JohnRaines/outlet-regulator/project/keypad wiring diagram (rev2).txt

keypad pin wiring

rows: (pin, gpio)
24, 8
26, 7
32, 12
36, 16

columns: (pin, gpio)
38, 20
40, 21
37, 26
