JohnRaines/outlet-regulator/project/baseplate 1.STL

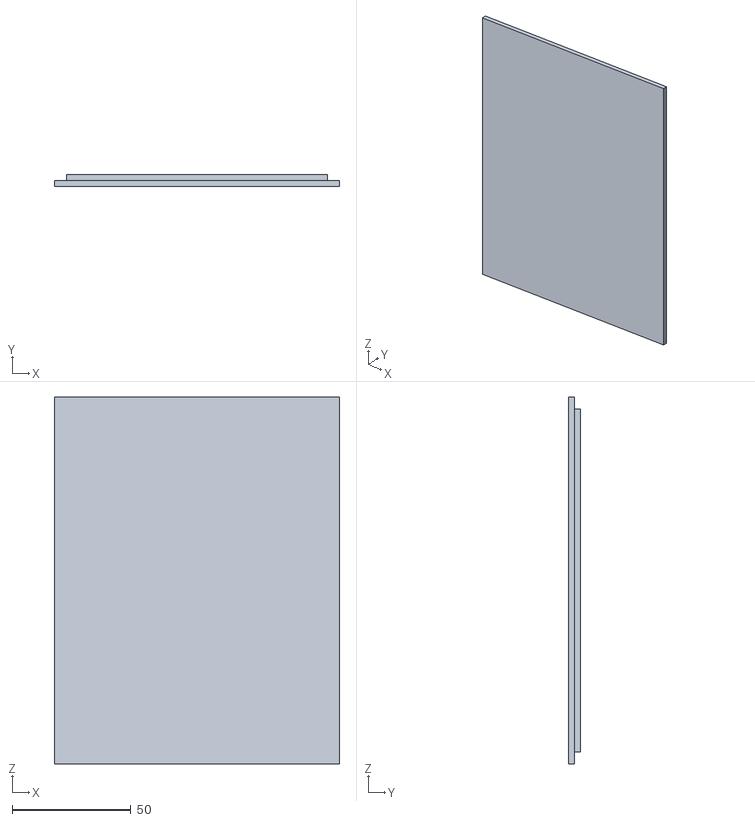
[picture p1: CAD file, 2017-04-18]
project/baseplate 1.STL
120.0 x 5.00 x 154.5
