JohnRaines/outlet-regulator/project/box 2 (holes).STL

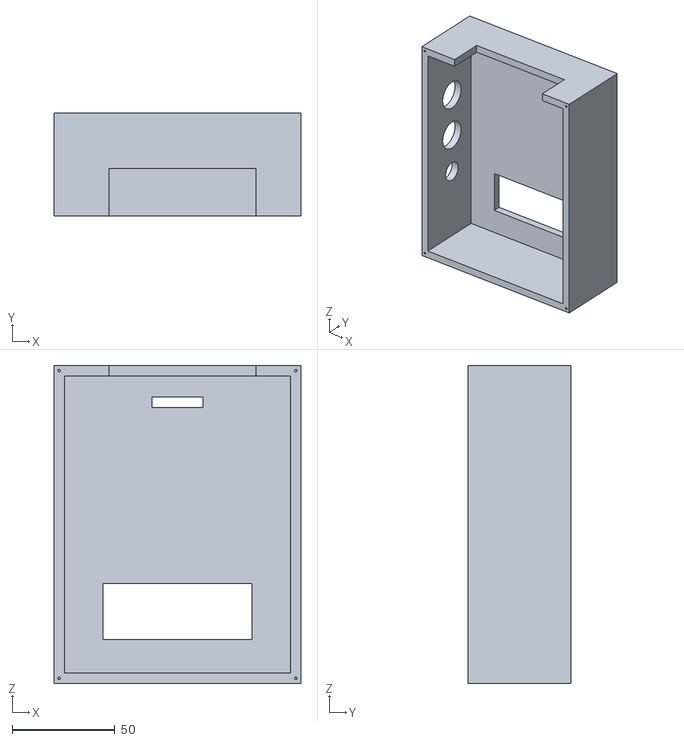
[picture p2: CAD file, 2017-04-18]
project/box 2 (holes).STL
120.0 x 50.0 x 154.5
