JohnRaines/outlet-regulator/project/Eagle Files/breakout rev 2.1.1/wiring.brd

## EAGLE design project/Eagle Files/breakout rev 2.1.1/wiring.brd (2017-02-02)

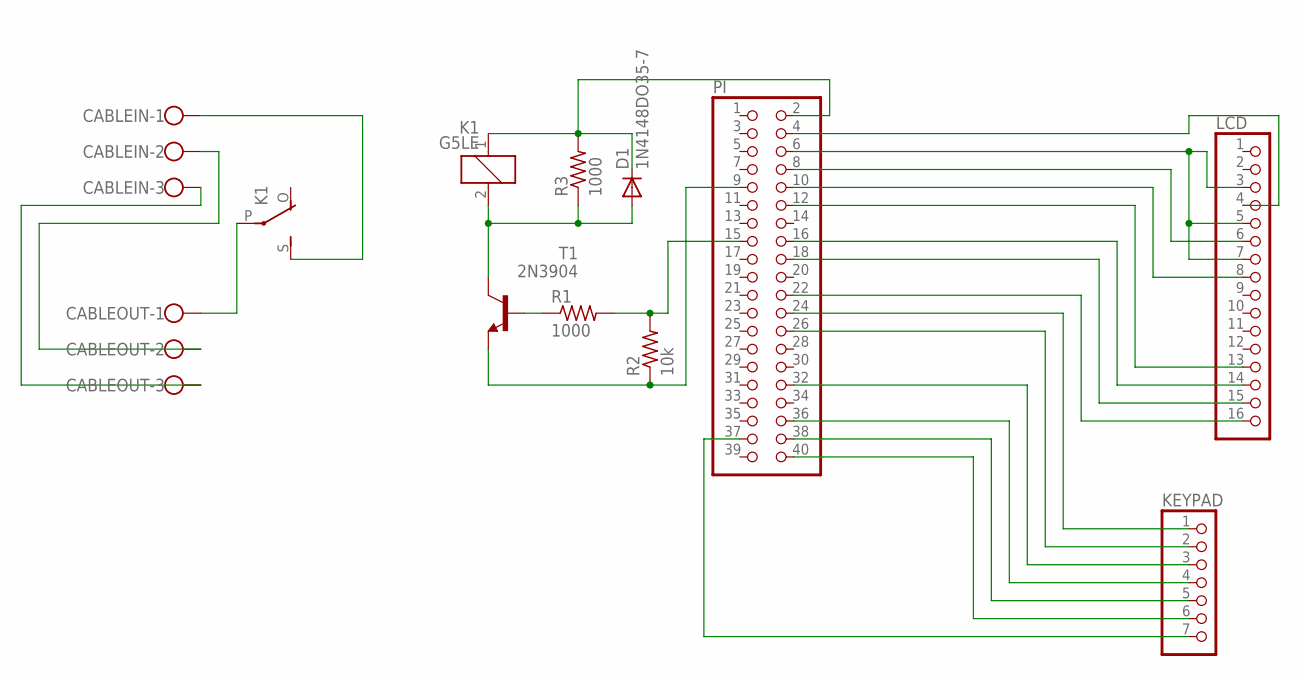
[picture p3: schematic wiring.sch, sheet 1]

Parts:
CABLEIN: W237-103
CABLEOUT: W237-103
D1: 1N4148DO35-7; DO35-7
K1: G5LE
KEYPAD: PINHD-1X7; 1X07
LCD: PINHD-1X16; 1X16
PI: PINHD-2X20; 2X20
R1, R3: 1000; 0204/5
R2: 10k; 0204/5
T1: 2N3904; TO92

Connections:
unnamed: CABLEOUT.1, K1.P
unnamed: D1.C, K1.1, PI.2, R3.2
unnamed: CABLEIN.1, K1.S
unnamed: CABLEIN.2, CABLEOUT.2
unnamed: CABLEIN.3, CABLEOUT.3
unnamed: LCD.3, LCD.5, LCD.7, PI.6
unnamed: LCD.4, PI.4
unnamed: LCD.6, PI.8
unnamed: LCD.8, PI.10
unnamed: LCD.14, PI.16
unnamed: LCD.13, PI.12
unnamed: LCD.15, PI.18
unnamed: LCD.16, PI.22
unnamed: KEYPAD.1, PI.24
unnamed: KEYPAD.2, PI.26
unnamed: D1.A, K1.2, R3.1, T1.1 (C)
unnamed: PI.9, R2.1, T1.3 (E)
unnamed: PI.15, R1.2, R2.2
unnamed: R1.1, T1.2 (B)
unnamed: KEYPAD.3, PI.32
unnamed: KEYPAD.4, PI.36
unnamed: KEYPAD.5, PI.38
unnamed: KEYPAD.6, PI.40
unnamed: KEYPAD.7, PI.37

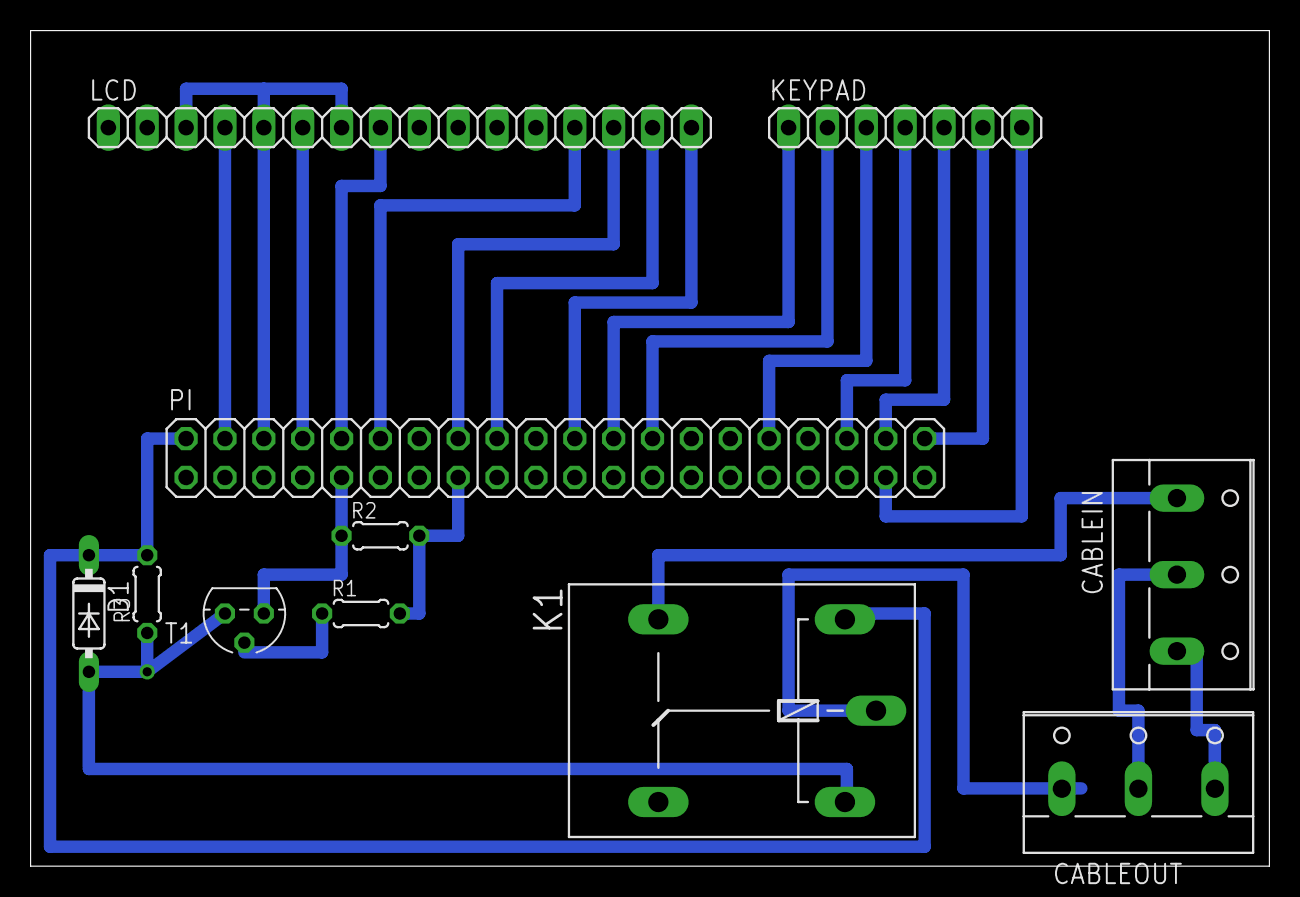
[picture p4: board wiring.brd from above]

Board: 2 copper layers, 81.0 x 54.6 mm, 11 parts (0 on the bottom side), 24 nets.
