JohnRaines/outlet-regulator/project/lcd wiring reference.txt

reference for which pins go to which
****pins NOT GPIO numbers****

Pi	lcd
6	1	(ground)
2	2	(+5V)
6	3	(ground)
26	4	(RS)
6	5	(RW)
24	6	(E)
x	7	(not used)
x	8	(not used)
x	9	(not used)
x	10	(not used)
22	11	(data 4)
18	12	(data 5)
16	13	(data 6)
12	14	(data 7)
x	15	(not used)
x	16	(not used)
