JohnRaines/outlet-regulator/project/Code/notes on current usages.txt

center2.py
	brain of the operation, contains main method and does all the logic stuff

keypad_functions.py
	has all the commands for reading from the keypad (called by center2)

lcd_functions.py
	has all the code for driving the lcd screen (thanks raspberrypi spy)(called by center2)

web_Scrape.py
	has the code for pulling the useful information from the http site. (called by center2)
