JohnRaines/outlet-regulator/(commit log)

2016-12-14 lcd driver script
    sample lcd driver script being used to test functionality
2016-12-14 updated 14 - 12 - 16
    added the lcd display, the keypad, and removed the arduino
2016-12-14 updated documentation
    added wiring reference for pi and lcd and updated the ssh/scp guide
2016-12-14 added python scripts
    center = current main driver for pi web interface
    web scraper = pulls data from site
    lcd functions = lcd drivers
2016-12-16 updated files
    added wiring guide for keypad and updated python scripts. Center2.py is
    new main app thing
2017-01-19 Cleaned up documentation
    revised descriptions and, updated center2 for relay driving
    capabilities, and moved obselte code to the "old" folder.
2017-01-24 Updated everything
    ~changed all code to clean up GPIO layout
    ~added eagle files for second version of pcb
    ~added master pin connection guide
    ~removed redundant txt files
    ~updated parts list
    [wiring.brd, wiring.sch]
2017-02-02 fixed pcb
    added missing trace that prevented the lcd from working.
    [wiring.brd, wiring.sch]
2017-02-02 fixed up pcb
    thickened trace that was unintentionally skinny
    [wiring.brd, wiring.sch]
2017-02-16 added stl files for testing bezels
    printer files for the bezels I used to double check the dimensions of the parts
    [keypad bezel.STL, lcd bezel.STL]
2017-02-16 moved printer files to folder
    I dont know why github's site was acting so weird about making folders
    [keypad bezel.STL, lcd bezel.STL]
2017-04-18 3d printer files for box
    [baseplate 1.STL, box 2 (holes).STL]
